Juventus-Technikerschule-HF/EduboardV2_ESP32/EduboardV2_ESP32_Schematic_V1.pdf

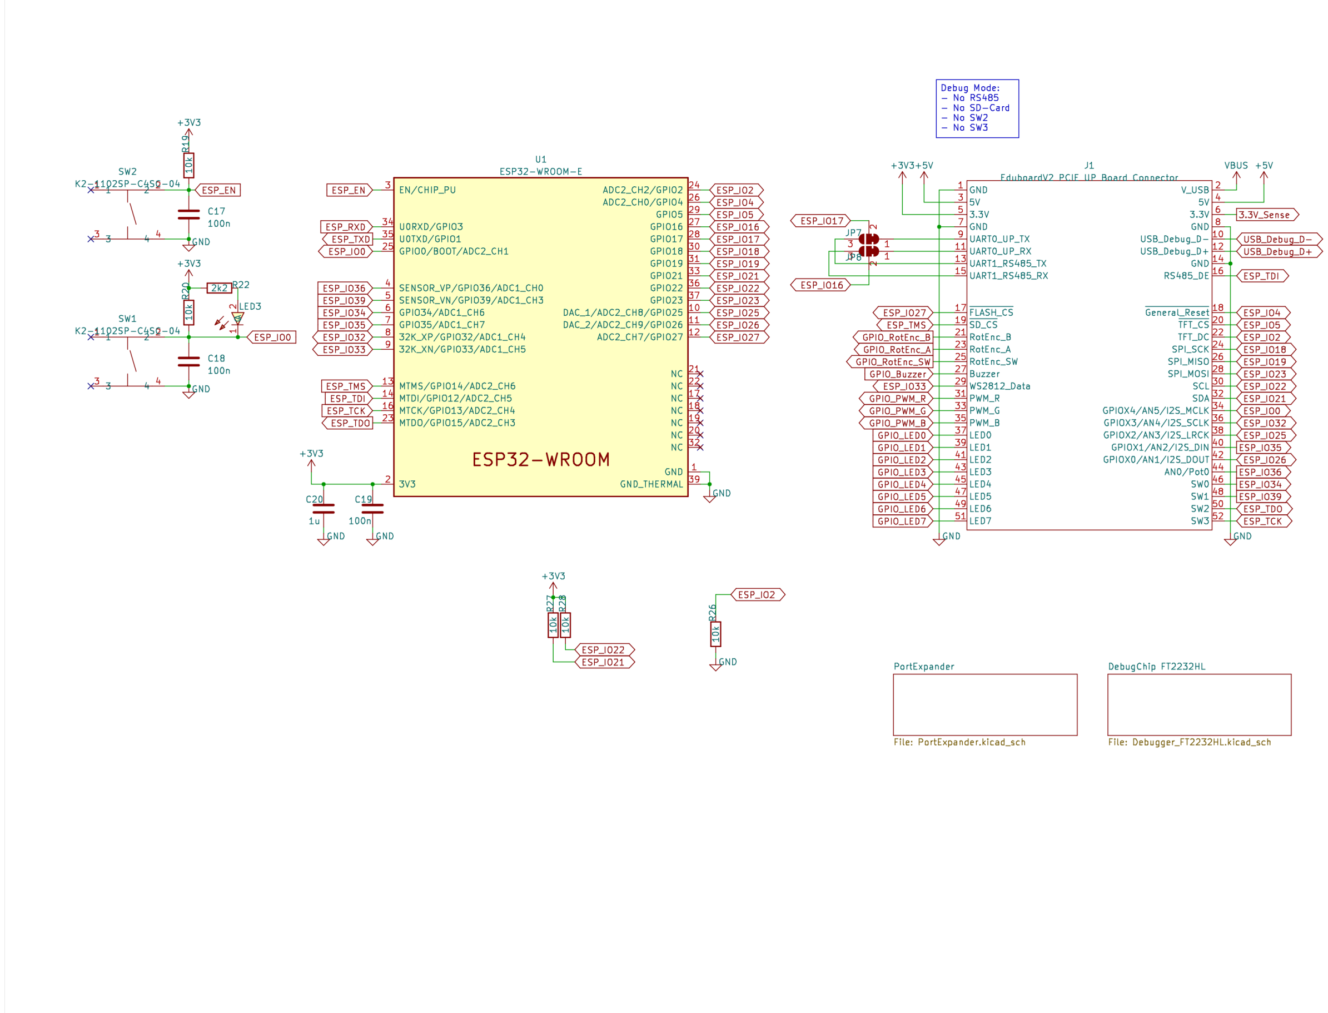
[picture p1: page 1]
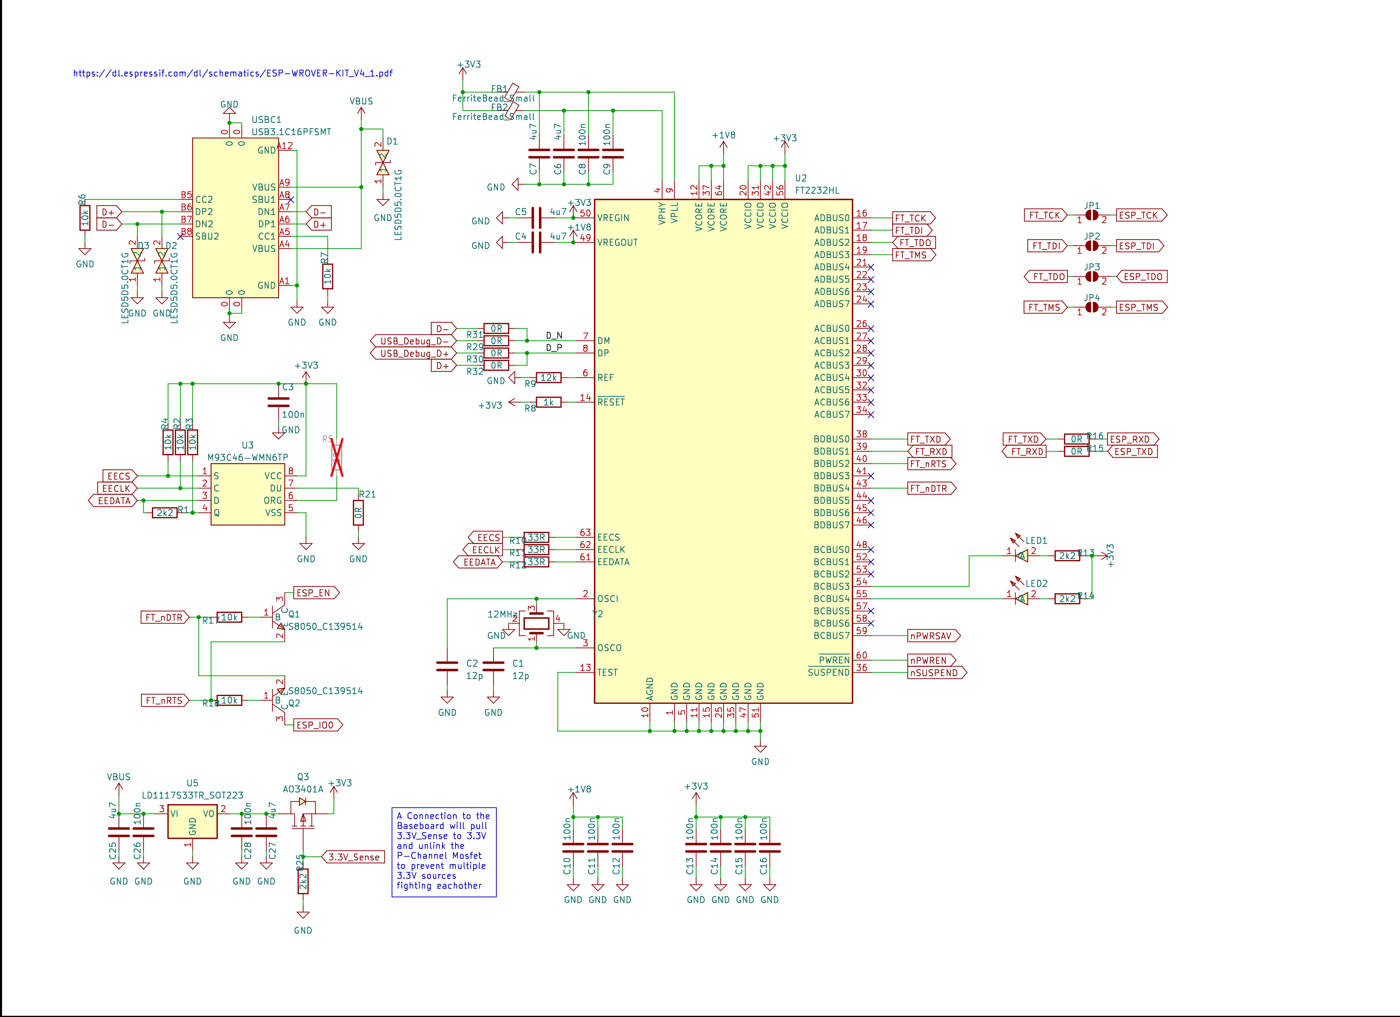
[picture p2: page 2]
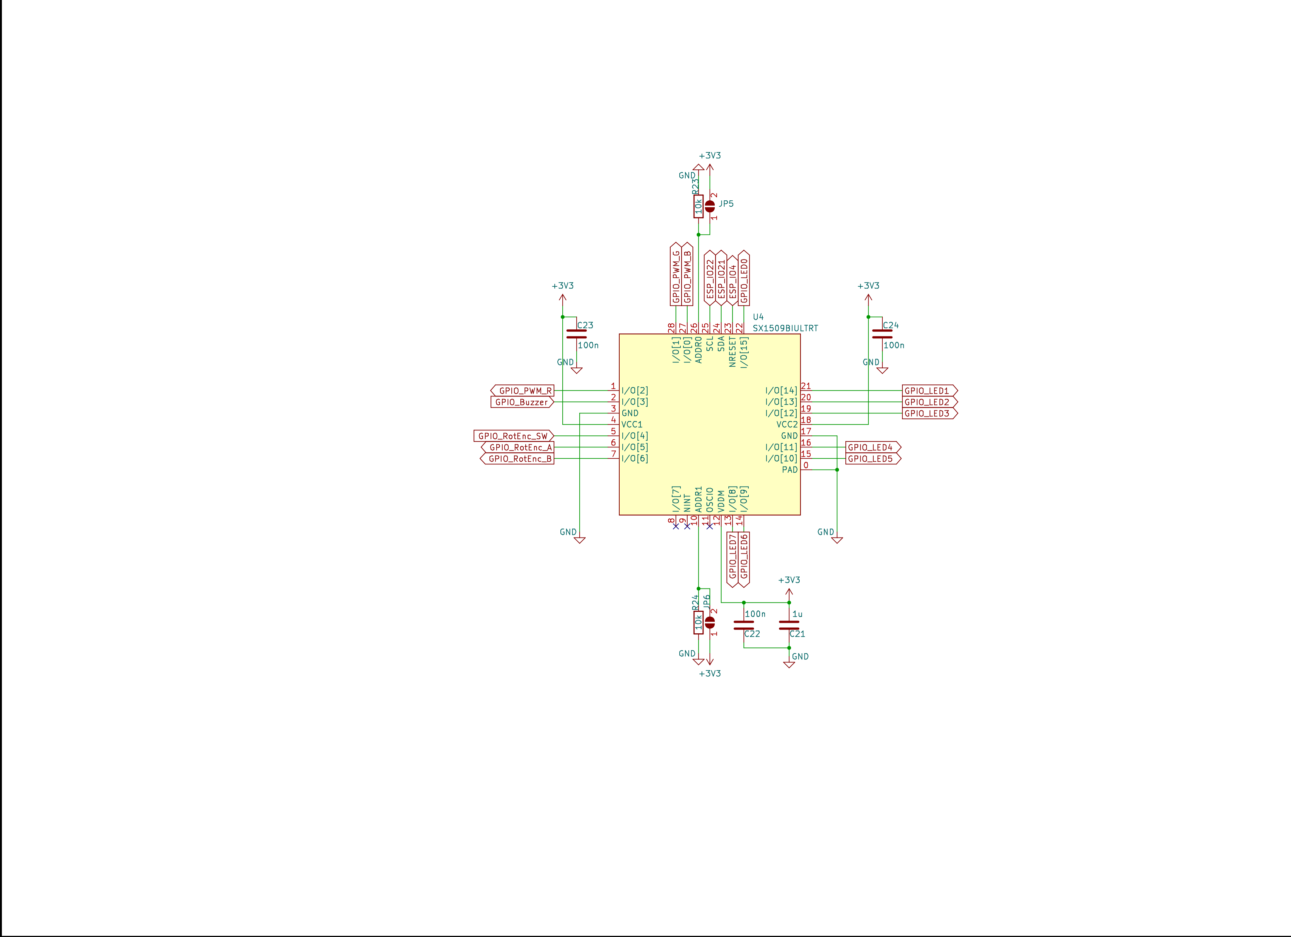
[picture p3: page 3]
