Juventus-Technikerschule-HF/EduboardV2_ESP32/pinout_minipcie.png

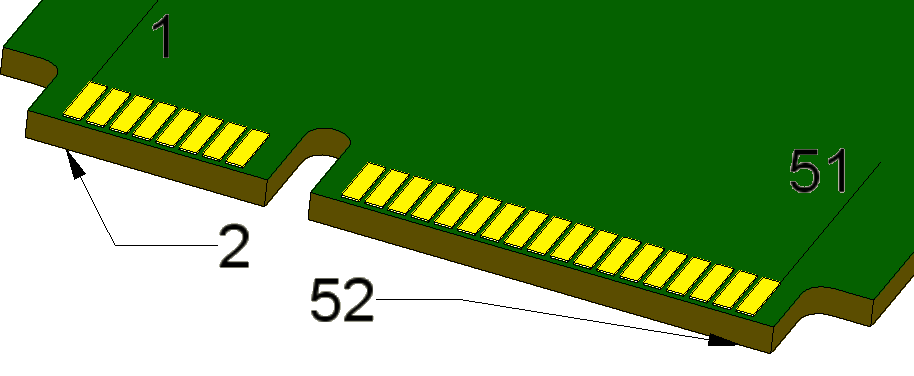
pinout_minipcie.png
