Juventus-Technikerschule-HF/EduboardV2_ESP32/EduboardV2_ESP32/EduboardV2_ESP32.kicad_pcb

## KiCad design EduboardV2_ESP32/EduboardV2_ESP32.kicad_pcb (2023-04-12)

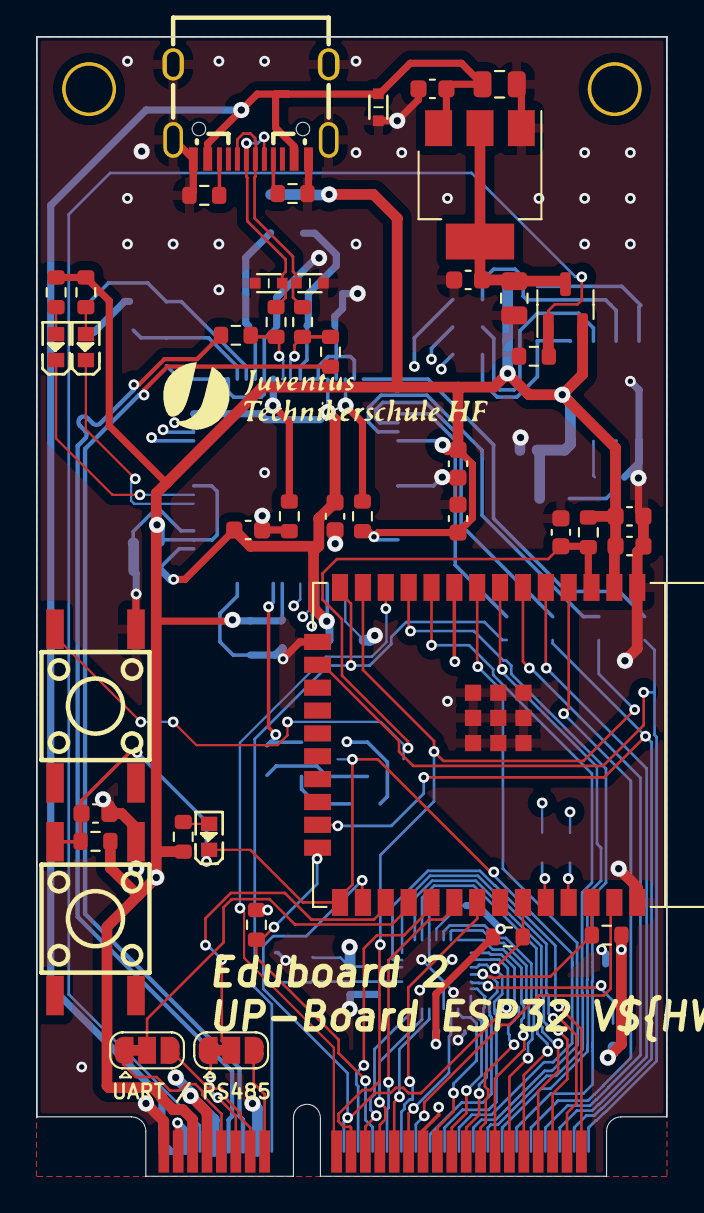
[picture p5: board EduboardV2_ESP32.kicad_pcb from above]

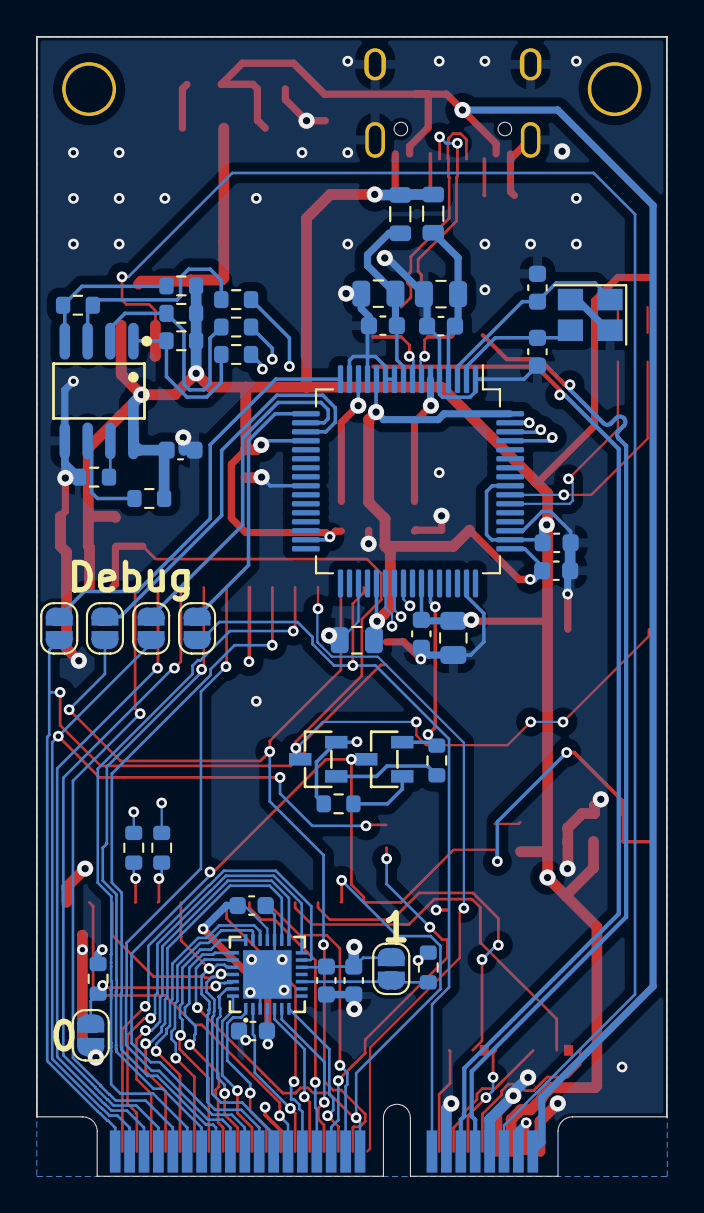
[picture p6: board EduboardV2_ESP32.kicad_pcb from below]

Board: 4 copper layers, 35.0 x 63.3 mm, 89 parts (45 on the bottom side), 93 nets.

Parts:
C1, C2: 12p; C_0603_1608Metric
C3, C8, C9, C10, C11, C12, C13, C14, C15, C16, C17, C18, C19, C22, C23, C24, C26, C28: 100n; C_0603_1608Metric
C4, C5, C6, C7, C25, C27: 4u7; C_0805_2012Metric
C20, C21: 1u; C_0603_1608Metric
D1, D2, D3: LESD5D5.0CT1G; SOD-523_L1.2-W0.8-LS1.6-BI
FB1, FB2: FerriteBead_Small; L_0805_2012Metric
J1: EduboardV2 PCIE UP Board Connector; mini-PCIe_F1_Full
JP1, JP2, JP3, JP4, JP5, JP6: SolderJumper_2_Open; SolderJumper-2_P1.3mm_Open_RoundedPad1.0x1.5mm
JP7, JP8: SolderJumper_3_Bridged12; SolderJumper-3_P1.3mm_Bridged12_RoundedPad1.0x1.5mm
LED1, LED2, LED3: 19-217/BHC-ZL1M2RY/3T; LED0603-FD_BLUE
Q1, Q2: S8050_C139514; SOT-23-3_L2.9-W1.3-P1.90-LS2.4-BR
Q3: AO3401A; SOT-23-3
R1, R13, R14, R22, R25: 2k2; R_0603_1608Metric
R2, R3, R4, R6, R7, R17, R18, R19, R20, R23, R24, R26, R27, R28: 10k; R_0603_1608Metric
R5, R15, R16, R21, R29, R30, R31, R32: 0R; R_0603_1608Metric
R8: 1k; R_0603_1608Metric
R9: 12k; R_0603_1608Metric
R10, R11, R12: 33R; R_0603_1608Metric
SW1, SW2: K2-1102SP-C4SC-04; KEY-SMD_4P-L6.0-W6.0-P4.50-LS9.5-BL
U1: ESP32-WROOM-E; ESP32-WROOM-32E
U2: FT2232HL; LQFP-64_10x10mm_P0.5mm
U3: M93C46-WMN6TP; SOIC-8_L4.9-W3.9-P1.27-LS6.0-BL
U4: SX1509BIULTRT; QFN-28_L4.0-W4.0-P0.40-BL-EP
U5: LD1117S33TR_SOT223; SOT-223-3_TabPin2
USBC1: USB3.1C16PFSMT; USB-C-SMD_TYPE-C-USB-17
Y2: 12MHz; Crystal_SMD_3225-4Pin_3.2x2.5mm

Connections:
3.3V_Sense: J1.6 (3.3V), Q3.1 (G), R25.1
+1V8: C4.2, C10.2, C11.2, C12.2, U2.12 (VCORE), U2.37 (VCORE), U2.49 (VREGOUT), U2.64 (VCORE)
+3V3: C3.1, C5.2, C13.2, C14.2, C15.2, C16.2, C19.1, C20.1, C21.2, C22.2, C23.1, C24.1, FB1.1, FB2.2, J1.5 (3.3V), JP5.2 (B), JP6.1 (A), Q3.2 (S), R2.1, R3.1, R4.1, R5.1, R8.1, R13.1, R14.1, R19.1, R20.1, R22.1, R27.1, R28.1, U1.2 (3V3), U2.20 (VCCIO), U2.31 (VCCIO), U2.42 (VCCIO), U2.50 (VREGIN), U2.56 (VCCIO), U3.8 (VCC), U4.4 (VCC1), U4.12 (VDDM), U4.18 (VCC2)
+5V: J1.3 (5V), J1.4 (5V)
/DebugChip FT2232HL/D_N: R29.2, R31.2, U2.7 (DM)
/DebugChip FT2232HL/D_P: R30.2, R32.2, U2.8 (DP)
D+: D2.2, R32.1, USBC1.A6 (DP1), USBC1.B6 (DP2)
D-: D3.2, R31.1, USBC1.A7 (DN1), USBC1.B7 (DN2)
EECLK: R2.2, R11.1, U3.2 (C)
EECS: R4.2, R10.1, U3.1 (S)
EEDATA: R1.2, R12.1, U3.3 (D)
ESP_EN: C17.1, Q1.3 (C), R19.2, SW2.2, U1.3 (EN/CHIP_PU)
ESP_IO0: C18.1, J1.34 (GPIOX4/AN5/I2S_MCLK), LED3.1 (C), Q2.3 (C), R20.2, SW1.2, U1.25 (GPIO0/BOOT/ADC2_CH1)
ESP_IO2: J1.22 (TFT_DC), R26.1, U1.24 (ADC2_CH2/GPIO2)
ESP_IO4: J1.18 (~General_Reset), U1.26 (ADC2_CH0/GPIO4), U4.23 (NRESET)
ESP_IO5: J1.20 (~TFT_CS), U1.29 (GPIO5)
ESP_IO16: JP8.2 (C), U1.27 (GPIO16)
ESP_IO17: JP7.2 (C), U1.28 (GPIO17)
ESP_IO18: J1.24 (SPI_SCK), U1.30 (GPIO18)
ESP_IO19: J1.26 (SPI_MISO), U1.31 (GPIO19)
ESP_IO21: J1.32 (SDA), R27.2, U1.33 (GPIO21), U4.24 (SDA)
ESP_IO22: J1.30 (SCL), R28.2, U1.36 (GPIO22), U4.25 (SCL)
ESP_IO23: J1.28 (SPI_MOSI), U1.37 (GPIO23)
ESP_IO25: J1.38 (GPIOX2/AN3/I2S_LRCK), U1.10 (DAC_1/ADC2_CH8/GPIO25)
ESP_IO26: J1.42 (GPIOX0/AN1/I2S_DOUT), U1.11 (DAC_2/ADC2_CH9/GPIO26)
ESP_IO27: J1.17 (~FLASH_CS), U1.12 (ADC2_CH7/GPIO27)
ESP_IO32: J1.36 (GPIOX3/AN4/I2S_SCLK), U1.8 (32K_XP/GPIO32/ADC1_CH4)
ESP_IO33: J1.29 (WS2812_Data), U1.9 (32K_XN/GPIO33/ADC1_CH5)
ESP_IO34: J1.46 (SW0), U1.6 (GPIO34/ADC1_CH6)
ESP_IO35: J1.40 (GPIOX1/AN2/I2S_DIN), U1.7 (GPIO35/ADC1_CH7)
ESP_IO36: J1.44 (AN0/Pot0), U1.4 (SENSOR_VP/GPIO36/ADC1_CH0)
ESP_IO39: J1.48 (SW1), U1.5 (SENSOR_VN/GPIO39/ADC1_CH3)
ESP_RXD: R16.1, U1.34 (U0RXD/GPIO3)
ESP_TCK: J1.52 (SW3), JP1.2 (B), U1.16 (MTCK/GPIO13/ADC2_CH4)
ESP_TDI: J1.16 (RS485_DE), JP2.2 (B), U1.14 (MTDI/GPIO12/ADC2_CH5)
ESP_TDO: J1.50 (SW2), JP3.2 (B), U1.23 (MTDO/GPIO15/ADC2_CH3)
ESP_TMS: J1.19 (~SD_CS), JP4.2 (B), U1.13 (MTMS/GPIO14/ADC2_CH6)
ESP_TXD: R15.1, U1.35 (U0TXD/GPIO1)
FT_RXD: R15.2, U2.39 (BDBUS1)
FT_TCK: JP1.1 (A), U2.16 (ADBUS0)
FT_TDI: JP2.1 (A), U2.17 (ADBUS1)
FT_TDO: JP3.1 (A), U2.18 (ADBUS2)
FT_TMS: JP4.1 (A), U2.19 (ADBUS3)
FT_TXD: R16.2, U2.38 (BDBUS0)
FT_nDTR: Q2.2 (E), R17.1, U2.43 (BDBUS4)
FT_nRTS: Q1.2 (E), R18.1, U2.40 (BDBUS2)
GND: C1.2, C2.2, C3.2, C4.1, C5.1, C6.1, C7.1, C8.1, C9.1, C10.1, C11.1, C12.1, C13.1, C14.1, C15.1, C16.1, C17.2, C18.2, C19.2, C20.2, C21.1, C22.1, C23.2, C24.2, C25.1, C26.1, C27.1, C28.1, D1.1, D2.1, D3.1, J1.1 (GND), J1.7 (GND), J1.8 (GND), J1.14 (GND), R6.2, R7.2, R9.1, R21.2, R23.1, R24.2, R25.2, R26.2, SW1.4, SW2.4, U1.1 (GND), U1.15 (GND), U1.38 (GND), U1.39 (GND_THERMAL), U2.1 (GND), U2.5 (GND), U2.10 (AGND), U2.11 (GND), U2.13 (TEST), U2.15 (GND), U2.25 (GND), U2.35 (GND), U2.47 (GND), U2.51 (GND), U3.5 (VSS), U4.0 (PAD), U4.3 (GND), U4.17 (GND), U5.1 (GND), USBC1.0, USBC1.A1 (GND), USBC1.A12 (GND), Y2.2, Y2.4
GPIO_Buzzer: J1.27 (Buzzer), U4.2 (I/O[3])
GPIO_LED0: J1.37 (LED0), U4.22 (I/O[15])
GPIO_LED1: J1.39 (LED1), U4.21 (I/O[14])
GPIO_LED2: J1.41 (LED2), U4.20 (I/O[13])
GPIO_LED3: J1.43 (LED3), U4.19 (I/O[12])
GPIO_LED4: J1.45 (LED4), U4.16 (I/O[11])
GPIO_LED5: J1.47 (LED5), U4.15 (I/O[10])
GPIO_LED6: J1.49 (LED6), U4.14 (I/O[9])
GPIO_LED7: J1.51 (LED7), U4.13 (I/O[8])
GPIO_PWM_B: J1.35 (PWM_B), U4.27 (I/O[0])
GPIO_PWM_G: J1.33 (PWM_G), U4.28 (I/O[1])
GPIO_PWM_R: J1.31 (PWM_R), U4.1 (I/O[2])
GPIO_RotEnc_A: J1.23 (RotEnc_A), U4.6 (I/O[5])
GPIO_RotEnc_B: J1.21 (RotEnc_B), U4.7 (I/O[6])
GPIO_RotEnc_SW: J1.25 (RotEnc_SW), U4.5 (I/O[4])
unnamed: J1.11 (UART0_UP_RX), JP8.1 (A)
unnamed: J1.9 (UART0_UP_TX), JP7.1 (A)
unnamed: J1.15 (UART1_RS485_RX), JP8.3 (B)
unnamed: J1.13 (UART1_RS485_TX), JP7.3 (B)
unnamed: JP5.1 (A), R23.2, U4.26 (ADDR0)
unnamed: JP6.2 (B), R24.1, U4.10 (ADDR1)
unnamed: LED1.2 (A), R13.2
unnamed: LED1.1 (C), U2.54 (BCBUS3)
unnamed: LED2.2 (A), R14.2
unnamed: LED2.1 (C), U2.55 (BCBUS4)
unnamed: LED3.2 (A), R22.2
unnamed: Q1.1 (B), R17.2
unnamed: Q2.1 (B), R18.2
unnamed: C27.2, C28.2, Q3.3 (D), U5.2 (VO)
unnamed: R11.2, U2.62 (EECLK)
unnamed: R10.2, U2.63 (EECS)
unnamed: R12.2, U2.61 (EEDATA)
unnamed: C2.1, U2.2 (OSCI), Y2.3
unnamed: C1.1, U2.3 (OSCO), Y2.1
unnamed: R9.2, U2.6 (REF)
unnamed: C6.2, C9.2, FB2.1, U2.4 (VPHY)
unnamed: C7.2, C8.2, FB1.2, U2.9 (VPLL)
unnamed: R8.2, U2.14 (~RESET)
unnamed: R21.1, U3.7 (DU)
unnamed: R5.2, U3.6 (ORG)
unnamed: R1.1, R3.2, U3.4 (Q)
unnamed: R7.1, USBC1.A5 (CC1)
unnamed: R6.1, USBC1.B5 (CC2)
USB_Debug_D+: J1.12 (USB_Debug_D+), R30.1
USB_Debug_D-: J1.10 (USB_Debug_D-), R29.1
VBUS: C25.2, C26.2, D1.2, J1.2 (V_USB), U5.3 (VI), USBC1.A4 (VBUS), USBC1.A9 (VBUS)
