Juventus-Technikerschule-HF/EduboardV2_ESP32/(commit log)

2023-03-15 work on debug chip
    [Debugger_FT2232HL.kicad_sch, EduboardV2_ESP32.kicad_sch]
2023-03-16 finalize ft2232 design, prepare esp pins, work on mpcie pinout
    [Debugger_FT2232HL.kicad_sch, EduboardV2_ESP32.kicad_pcb, EduboardV2_ESP32.kicad_sch]
2023-03-20 add Portexpander, connect mPCIE
    [Debugger_FT2232HL.kicad_sch, EduboardV2_ESP32.kicad_sch, PortExpander.kicad_sch]
2023-03-20 all parts placed. descision about usb-debug line to be made...
    [Debugger_FT2232HL.kicad_sch, EduboardV2_ESP32.kicad_pcb, EduboardV2_ESP32.kicad_sch, PortExpander.kicad_sch]
2023-03-20 add voltage selector to prevent fighting sources
    [Debugger_FT2232HL.kicad_sch, EduboardV2_ESP32.kicad_pcb, EduboardV2_ESP32.kicad_sch]
2023-03-21 rework pin assignement with esp32 pin restrictions in mind. start layout
    [EduboardV2_ESP32.kicad_pcb, EduboardV2_ESP32.kicad_sch, PortExpander.kicad_sch]
2023-03-21 resize mPCIE Board Footprint, work on ESP32 UP Board
    [Debugger_FT2232HL.kicad_sch, EduboardV2_ESP32.kicad_pcb, EduboardV2_ESP32.kicad_sch]
2023-03-23 work on layout
    [EduboardV2_ESP32.kicad_pcb]
2023-04-08 layout done so far. Have to check everything and work on footprints in general. Changed to 4 layer (was not possible otherwise)
    [Debugger_FT2232HL.kicad_sch, EduboardV2_ESP32.kicad_pcb]
2023-04-11 finalize Layout, fill in most of the critical part info. Replace certain parts with Eduboard kicadlib Parts.
    [Debugger_FT2232HL.kicad_sch, EduboardV2_ESP32.kicad_pcb, EduboardV2_ESP32.kicad_sch]
2023-04-12 finalize Data. Add Logo and Text
    [Debugger_FT2232HL.kicad_sch, EduboardV2_ESP32.kicad_pcb, EduboardV2_ESP32.kicad_sch, PortExpander.kicad_sch]
2023-04-12 add gnd vias. Improve USB Diff Line. Work on finalization of pcb
    [EduboardV2_ESP32.kicad_pcb]
2023-04-16 add schematic V1 as PDF
2023-04-25 update 3d render of pcb for baseboard 3d render
